akorzunin/Photodiode_preamplifier/README.md

# Photodiode_preamplifier
 The device is designed for use in a Fourier spectrometer as a photodetector 
 
 Configurations
===

## Scheme 1
sheme2

### Вариант 1
Схема с двуканальным усилителем в первом каскаде и одноканальным усилителем во втором каскаде
| **Перемычка** | **Состояние** |
|--|--|
|PDG1|замкнута|
|OP6|замкнута|
|OP7|разомкнута|
|OP5|разомкнута|
|OP8|замкнута|
|CCH1|разомкнута|
### Вариант 2
Схема с одним двухканальным усилителем, где используется два каскада усиления
| **Перемычка** | **Состояние** |
|--|--|
|PDG1|замкнута|
|OP6|разомкнута|
|OP7|замкнута|
|OP5|замкнута|
|OP8|разомкнута|
|CCH1|разомкнута|

Между коннекторами C8 и С9 ставится пара резистор и конденсатор обратной связи Cf = 10pf, Rf = 300k. Данные значения подбираяюся в зависимости от используемого фотодиода.

## Scheme 2

sheme1
### Описание:
Крупноразмерная схема с одним двухканальным усилителем, где используется два каскада усиления
| **Перемычка** | **Состояние** |
|--|--|
|JUMPER1|замкнута|
|COAX1|разомкнута|
|OP1|замкнута|
|OP2|разомкнута|
|OP3|замкнута|
|OP4|разомкнута|

Между коннекторами C1 и С3 ставится пара резистор и конденсатор обратной связи Cf = 10pf, Rf = 300k. Данные значения подбираяюся в зависимости от используемого фотодиода.

 ## Scheme 3
fixed_sheme4

### Описание:
Крупноразмерная схема с двумя одноканальными усилителями

## Scheme 4

sheme3
### Описание:
Мелкоразмерная схема с двумя одноканальными усилителями

<!--stackedit_data:
eyJoaXN0b3J5IjpbLTM0MzU4ODU0NCwtODA3NTQ2MDYyLC0xMj
Q3ODIxMzUyLDE5MTQ3MDU3NjksMTY2ODgwMjQ3NSwtMTI2ODE1
NDYxLC0xMDk3NDg0NTM0XX0=
-->
