akorzunin/Photodiode_preamplifier/Preamp.PDF

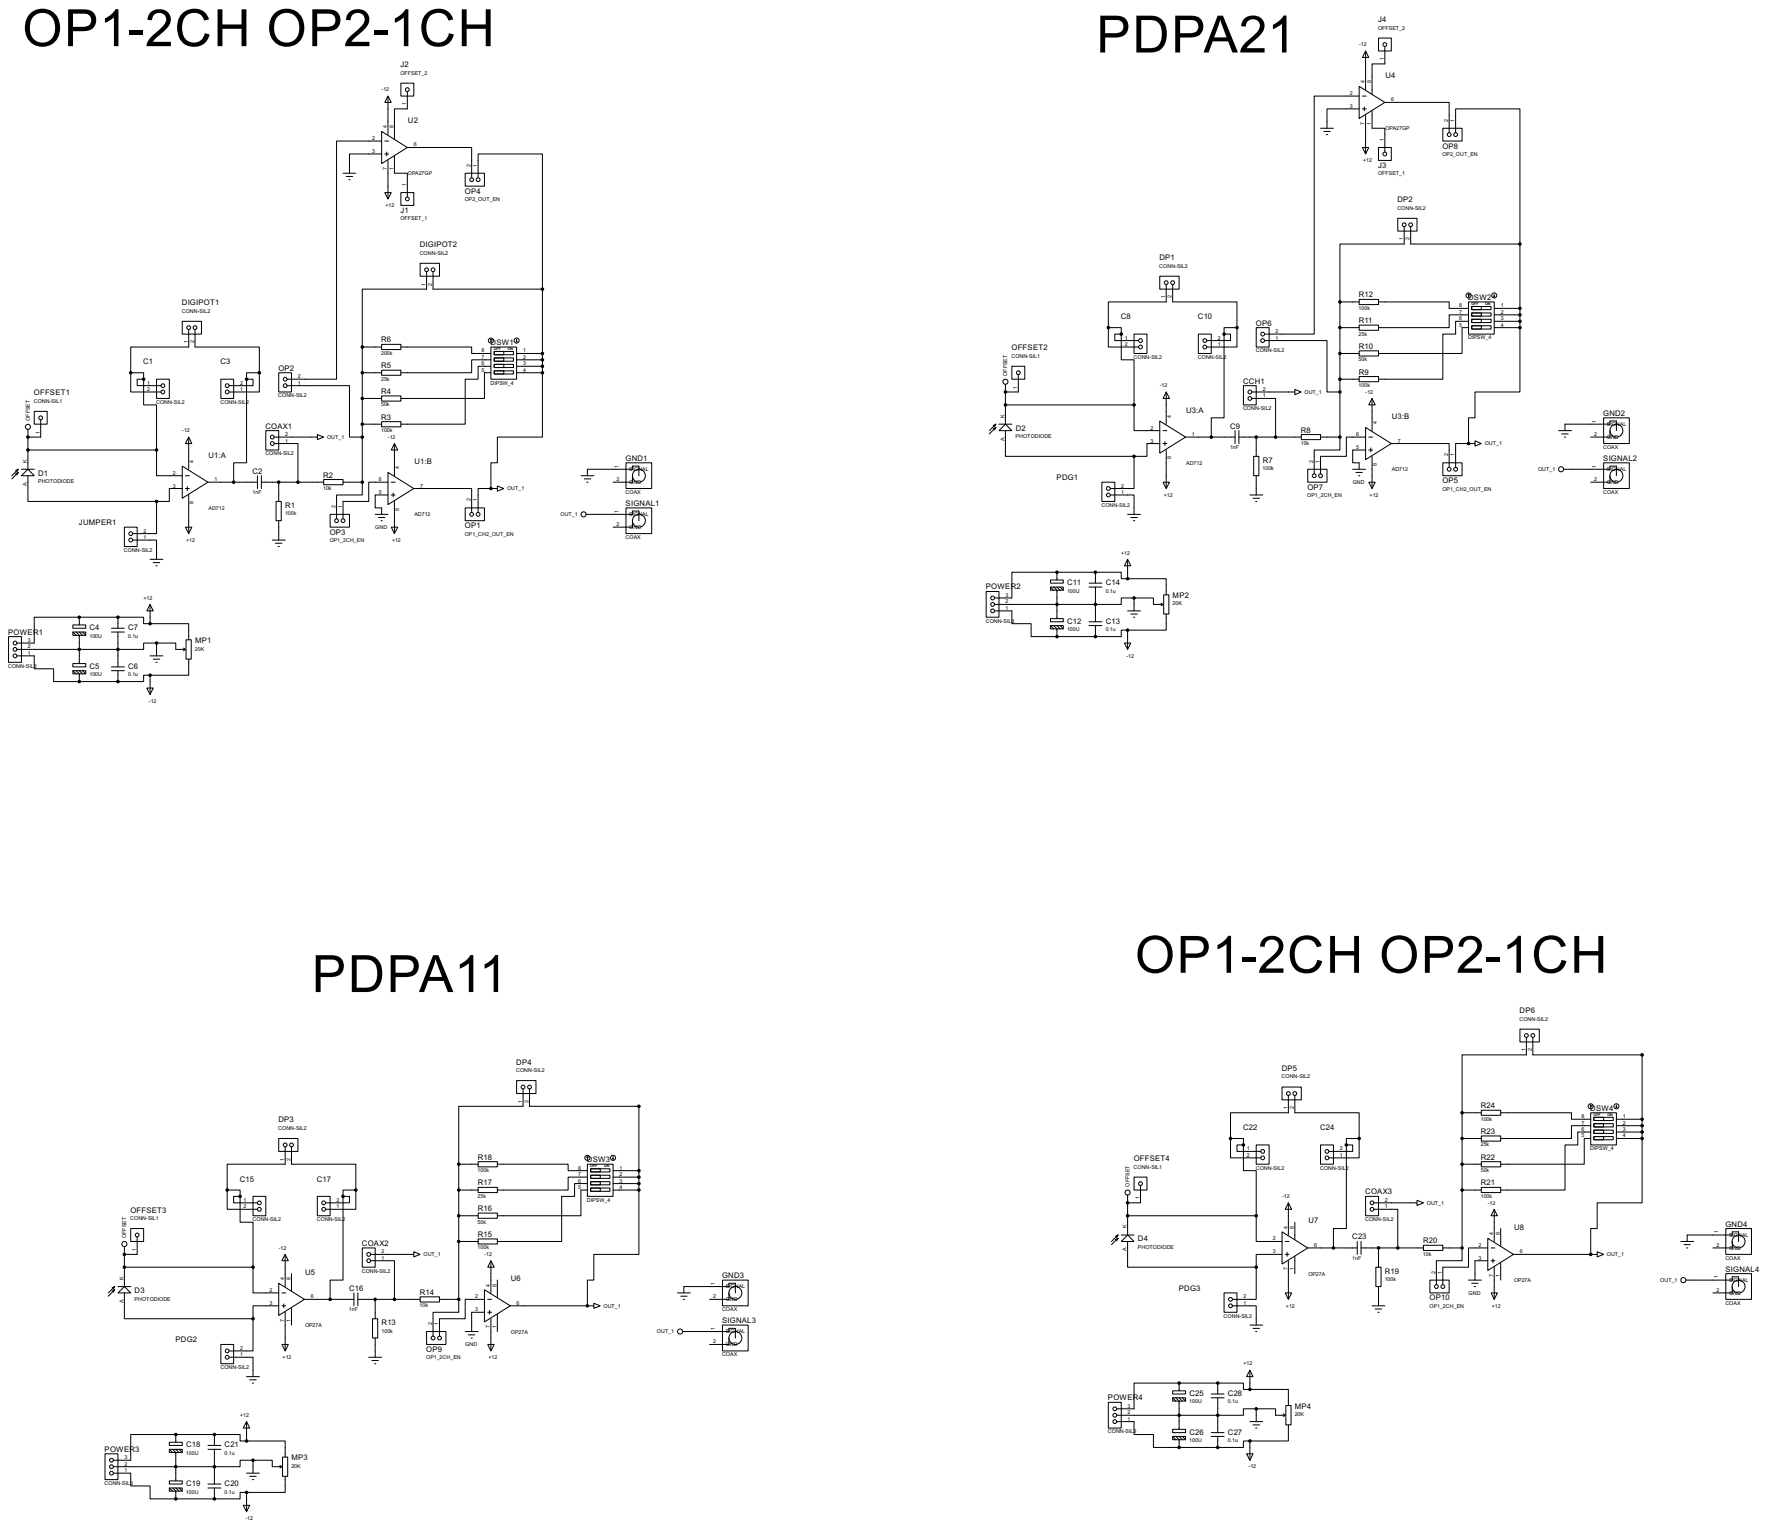
[picture p4: page 1]
