akorzunin/Photodiode_preamplifier/(list of files, drawings)

Other design files:
PD_Preamp_PCB_ALL_2.pdsprj
